Flameeyes/blister-buster/(commit log)

2024-06-23 Actual initial import.
    This adds the OpenSCAD file, as well
    as the documentation.
    [blister-buster.scad]
2024-07-04 Update the script to use external dimensions, document.
    Instead of measuring the spacing between pills,
    measure the outer dimensions, so that it's easier.
    This also adds a larger tolerance to the grid for ease of printing.
    [blister-buster.scad]
2024-07-05 Reduce the overside of the hopes to 5%, update docs.
    [blister-buster.scad]
2025-08-08 Add 0.001 fudges to avoid artifacts in pre-render.
    [blister-buster.scad]
2025-08-10 Add the ability to define a non-round pill size.
    Turns out my latest metformin pill is oblong.
    So now I'm defining the pill size in weidth×length insted of just diameter.
    [blister-buster.scad]
